Open-tES/Electronic/Open_tES.pdf

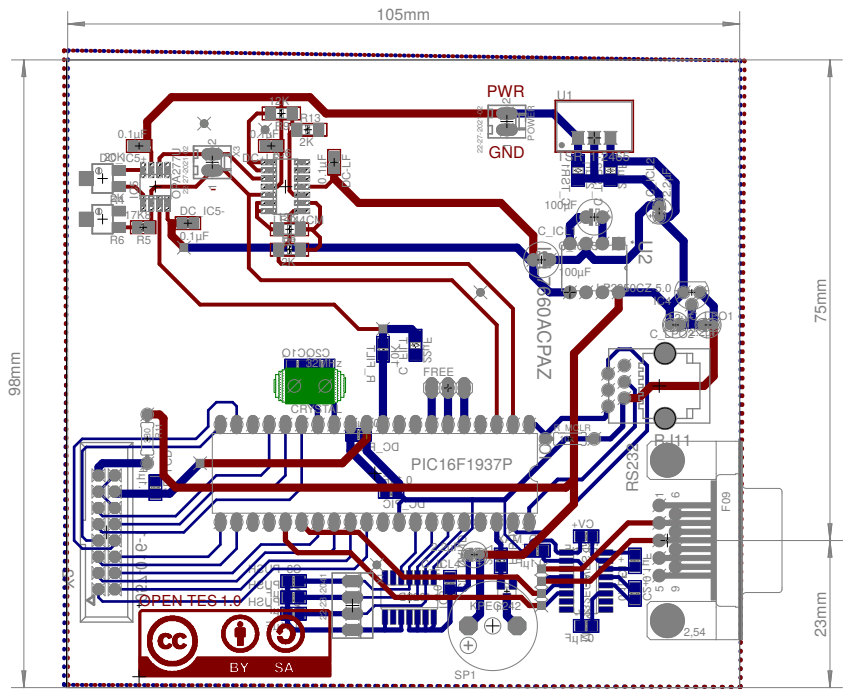
[picture p1: page 1]

Fp22 2K7 057-016-1 Fp22 22µF 22µF MAX232ECWES Fµ1. 0 Fµ1. 0 0.1µF0.1µF D3204 Fµ1. 0 0.1µF Fµ10. 0 Fµ10. 0 Fµ10. 0 22µF 10K 0.1µF Fµ1. 0 Fµ1. 0 Q2 C R_BUZZ X2 Q1 C C_TSR1 C_TSR2 2 CI +VC - VC C2+ C- 1+- IC3 CI P_ CD CD_NAND HSUP_3 C HSUP_2 C HSUP_1 C C_FILT R_FILT CD_LCD XA M_ DC 1 CI P_ CD 1T PWR GND - OPEN TES 1.0 1 59 6 2,54 F09 1 21 2 * RS232 CRYSTAL RJ11 R_MCLR R5 XIC6 3 R11 R1 R9 R13 R8 POWER U1 IC4 U2 C_ICL2 C_ICL1 C_ICL3 C_LPO1 SP1 R6 IC5 R4 DC_IC5+ DC_IC5- DC+LF DC-LF X1 C_LPO2 C_ICL4 FREE IC7 32MHz 10k 17K8 LF444CM 22-27-2021-02 330 12K 12K 2K 2K 22-27-2021-02 TSR_1-2465 LP2950CZ-5.0 ICL7660ACPAZ 2.2µF 100µF 100µF 2.2µF KPEG242 2K OPA277U20K0.1µF 0.1µF 0.1µF 0.1µF 22-23-2041 2.2µF 2.2µF PIC16F1937P 98mm 105mm 75mm 23mm
