Open-tES/Electronic/BOTTOM_PCB.pdf

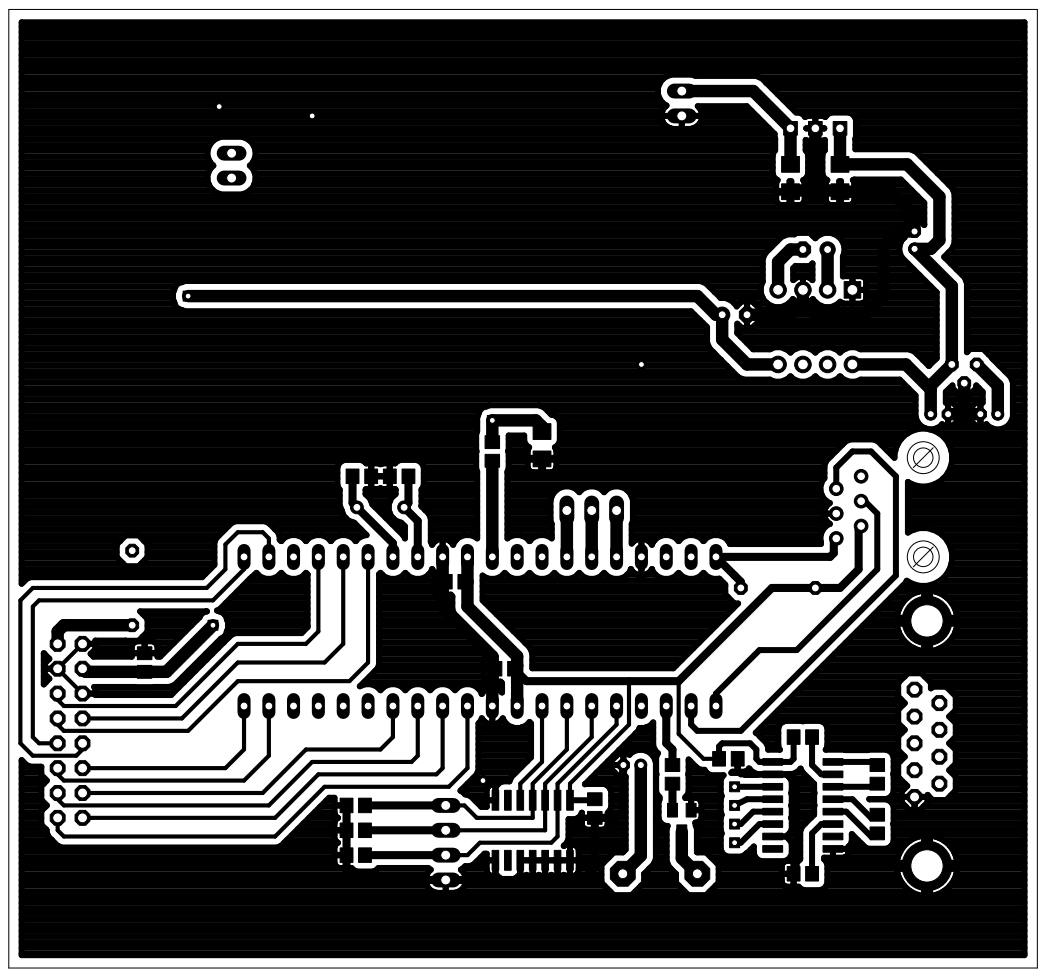
[picture p2: page 1]
