Open-tES/Electronic/TOP_PCB.pdf

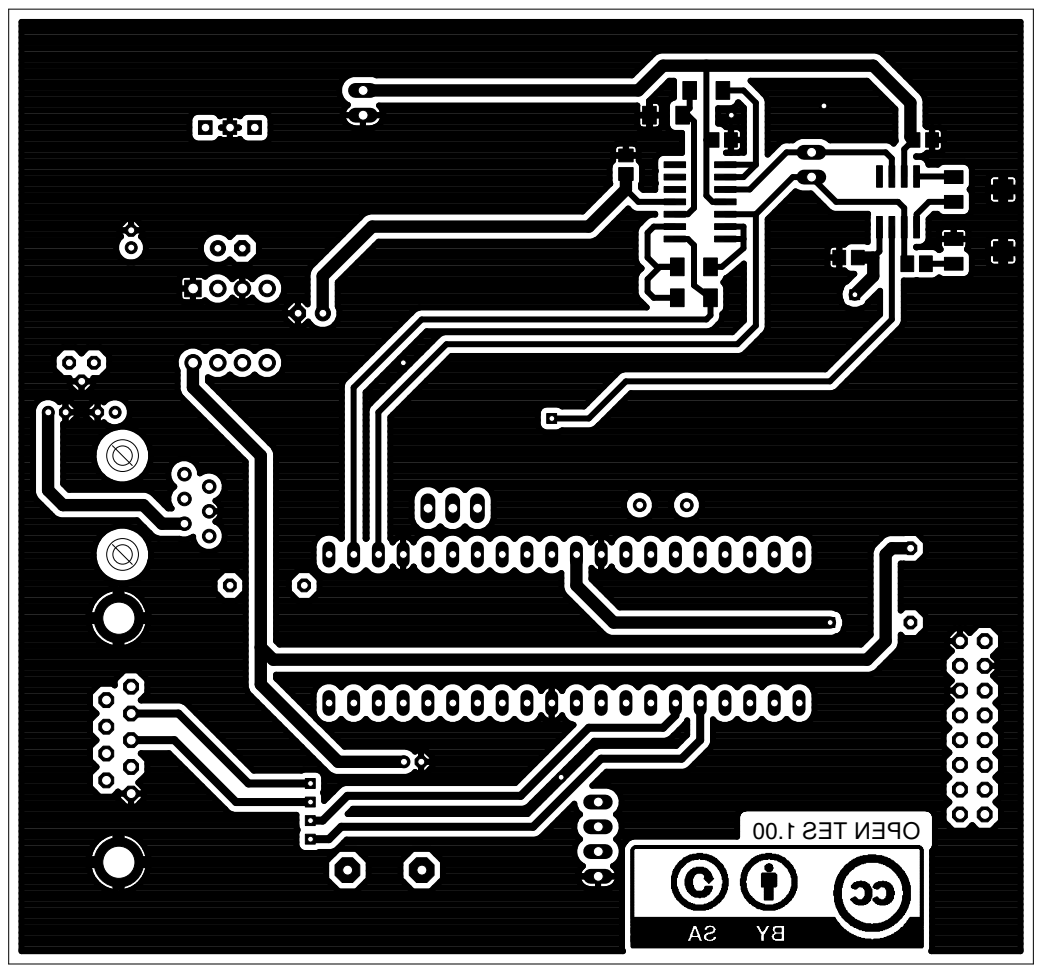
[picture p3: page 1]
