Open-tES/Electronic/Open_tES.brd

## EAGLE design Open_tES.brd (2016-03-02)

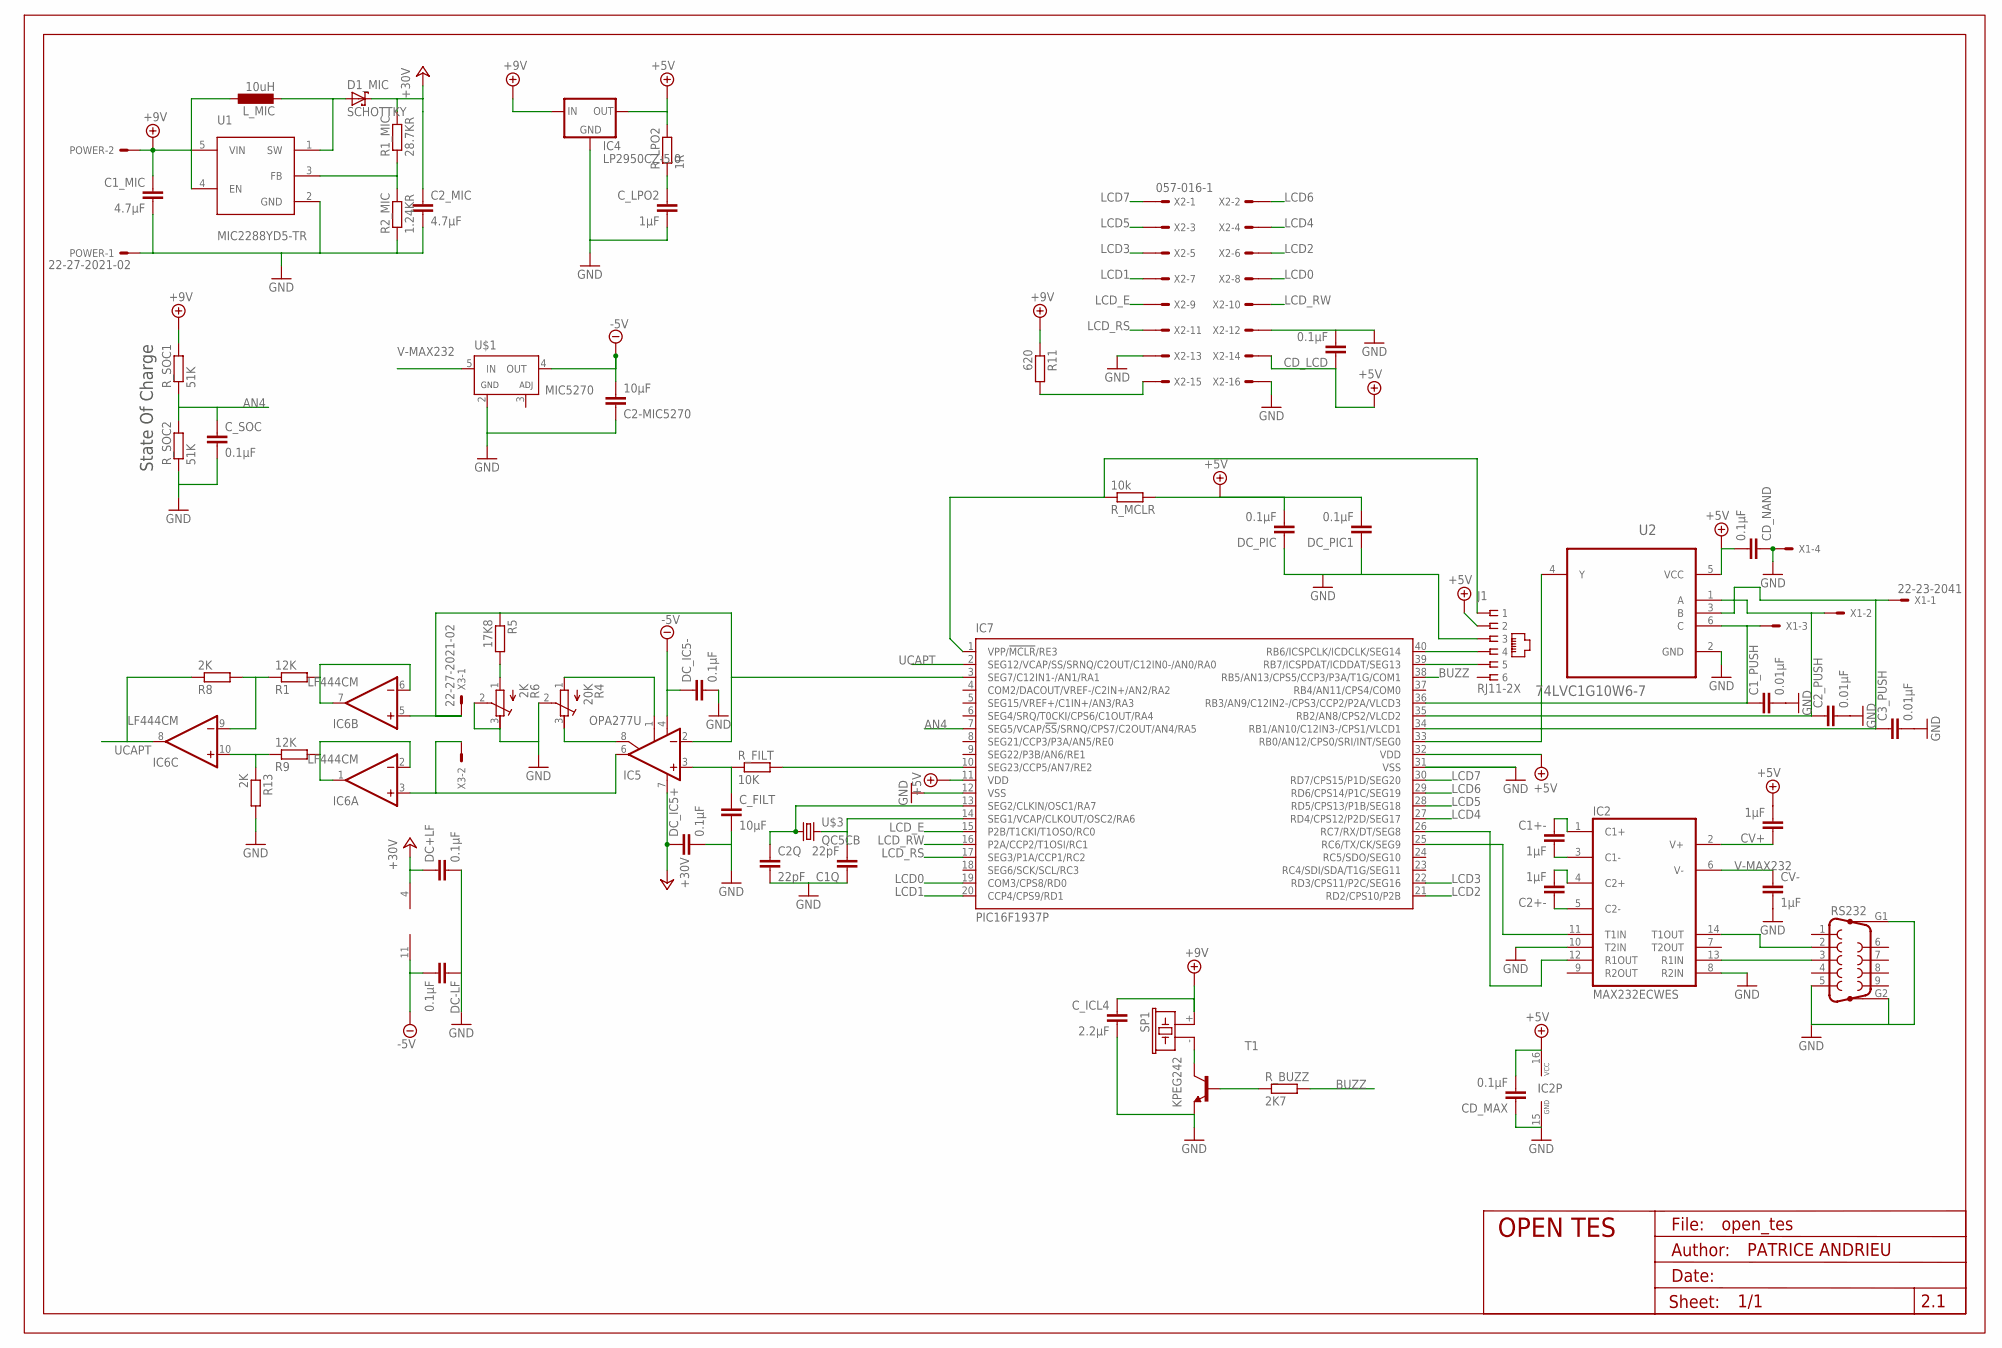
[picture p4: schematic Open_tES.sch]

Parts:
C1+-, C2+-: 1µF; C0805
C1Q, C2Q: 22pF; C0805
C1_MIC, C2_MIC: 4.7µF; C0805
C1_PUSH, C2_PUSH, C3_PUSH: 0.01µF; C0805
C2-MIC5270: 10µF; C0805
CD_LCD: 0.1µF; C0805
CD_MAX: 0.1µF; C0805
CD_NAND: 0.1µF; C0805
CV+: 1µF; C0805
CV-: 1µF; C0805
C_FILT: 10µF; C0805
C_ICL4: 2.2µF; C0805K
C_LPO2: 1µF; C0805
C_SOC: 0.1µF; C0805
D1_MIC: SCHOTTKY; SOD80
DC+LF: 0.1µF; C0805
DC-LF: 0.1µF; C0805
DC_IC5+, DC_IC5-: 0.1µF; C0805
DC_PIC, DC_PIC1: 0.1µF; C0805
IC2: MAX232ECWES; SO16
IC4: LP2950CZ-5.0; TO92
IC5: OPA277U; SO08
IC6: LF444CM; SO14
IC7: PIC16F1937P; DIL40
J1: RJ11-2X; RJ11-NO_SHIELD
L_MIC: 10uH; L2012C
POWER: 22-27-2021-02; 6410-02
R1, R9: 12K; R0805
R1_MIC: 28.7KR; R0805
R2_MIC: 1.24KR; R0805
R4: 20K; RTRIM3214W
R5: 17K8; M0805
R6: 2K; RTRIM3214W
R8, R13: 2K; R0805
R11: 620; 0204/7
RS232: F09HP
R_BUZZ: 2K7; R0805
R_FILT: 10K; R0805
R_LPO2: 1R; R0805
R_MCLR: 10k; 0204/7
R_SOC1, R_SOC2: 51K; R0805
SP1: KPEG242
T1: BFR92-NPN-SOT23-BEC; SOT23-BEC
U1: MIC2288YD5-TR; SOT23-5L
U2: 74LVC1G10W6-7; SOT95P280X135-6N
U$1: MIC5270; SOT23-5L
U$3: QC5CB
U$4: FRAME; OPEN_TE_VERSION
X1: 22-23-2041
X2: 057-016-1
X3: 22-27-2021-02; 6410-02

Connections:
+5V/1: CD_LCD.1, CD_MAX.2, CD_NAND.2, CV+.2, DC_PIC.2, DC_PIC1.2, IC2.16 (VCC), IC4.1 (OUT), IC7.11 (VDD), IC7.32 (VDD), J1.2, R_LPO2.2, R_MCLR.2, U2.5 (VCC), X2.14
+9V: C1_MIC.1, C_ICL4.1, IC4.3 (IN), L_MIC.1, POWER.2, R11.1, R_SOC1.2, SP1.+ (1), U1.4 (EN), U1.5 (VIN)
+30V: C2_MIC.1, D1_MIC.C, DC+LF.1, DC_IC5+.1, IC5.7 (V+), IC6.4 (V+), R1_MIC.2
-5V: C2-MIC5270.2, DC-LF.2, DC_IC5-.1, IC5.4 (V-), IC6.11 (V-), U$1.4 (OUT)
AN4: C_SOC.1, IC7.7 (SEG5/VCAP/!SS!/SRNQ/CPS7/C2OUT/AN4/RA5), R_SOC1.1, R_SOC2.2
BUZZ: IC7.38 (RB5/AN13/CPS5/CCP3/P3A/T1G/COM1), R_BUZZ.2
GND: C1Q.1, C1_MIC.2, C1_PUSH.2, C2-MIC5270.1, C2Q.2, C2_MIC.2, C2_PUSH.2, C3_PUSH.2, CD_LCD.2, CD_MAX.1, CD_NAND.1, CV-.2, C_FILT.2, C_ICL4.2, C_LPO2.2, C_SOC.2, DC+LF.2, DC-LF.1, DC_IC5+.2, DC_IC5-.2, DC_PIC.1, DC_PIC1.1, IC2.8 (R2IN), IC2.10 (T2IN), IC2.15 (GND), IC4.2 (GND), IC7.12 (VSS), IC7.31 (VSS), J1.3, POWER.1, R2_MIC.1, R4.2 (S), R6.2 (S), R6.3 (E), R13.2, RS232.5, RS232.G1, RS232.G2, R_SOC2.1, T1.E, U1.2 (GND), U2.2 (GND), U$1.2 (GND), X1.4, X2.12, X2.13, X2.16
ICAPT: IC5.2 (-IN), IC6.5 (+IN), IC7.3 (SEG7/C12IN1-/AN1/RA1), R5.1, X3.1
LCD0: IC7.19 (COM3/CPS8/RD0), X2.8
LCD1: IC7.20 (CCP4/CPS9/RD1), X2.7
LCD2: IC7.21 (RD2/CPS10/P2B), X2.6
LCD3: IC7.22 (RD3/CPS11/P2C/SEG16), X2.5
LCD4: IC7.27 (RD4/CPS12/P2D/SEG17), X2.4
LCD5: IC7.28 (RD5/CPS13/P1B/SEG18), X2.3
LCD6: IC7.29 (RD6/CPS14/P1C/SEG19), X2.2
LCD7: IC7.30 (RD7/CPS15/P1D/SEG20), X2.1
LCD_E: IC7.15 (P2B/T1CKI/T1OSO/RC0), X2.9
LCD_RS: IC7.17 (SEG3/P1A/CCP1/RC2), X2.11
LCD_RW: IC7.16 (P2A/CCP2/T1OSI/RC1), X2.10
MCLR: IC7.1 (VPP/!MCLR!/RE3), J1.1, R_MCLR.1
unnamed: SP1.- (2), T1.C
unnamed: IC6.6 (-IN), IC6.7 (OUT), R1.2
unnamed: C1+-.1, IC2.1 (C1+)
unnamed: R5.2, R6.1 (A)
unnamed: C2+-.2, IC2.4 (C2+)
unnamed: C1Q.2, IC7.14 (SEG1/VCAP/CLKOUT/OSC2/RA6), U$3.2
unnamed: IC2.14 (T1OUT), RS232.2
unnamed: IC2.13 (R1IN), RS232.3
unnamed: C3_PUSH.1, IC7.34 (RB1/AN10/C12IN3-/CPS1/VLCD1), U2.3 (B), X1.1
unnamed: R1_MIC.1, R2_MIC.2, U1.3 (FB)
unnamed: IC2.11 (T1IN), IC7.25 (RC6/TX/CK/SEG9)
unnamed: R_BUZZ.1, T1.B
unnamed: IC6.10 (+IN), R9.1, R13.1
unnamed: IC6.9 (-IN), R1.1, R8.2
unnamed: IC2.12 (R1OUT), IC7.26 (RC7/RX/DT/SEG8)
unnamed: IC5.8 (CMP2), R4.3 (E)
unnamed: IC6.1 (OUT), IC6.2 (-IN), R9.2
unnamed: C1_PUSH.1, IC7.36 (RB3/AN9/C12IN2-/CPS3/CCP2/P2A/VLCD3), U2.6 (C), X1.3
unnamed: C_FILT.1, IC5.3 (+IN), R_FILT.1
unnamed: C2Q.1, IC7.13 (SEG2/CLKIN/OSC1/RA7), U$3.1
unnamed: C_LPO2.1, R_LPO2.1
unnamed: C1+-.2, IC2.3 (C1-)
unnamed: C2_PUSH.1, IC7.35 (RB2/AN8/CPS2/VLCD2), U2.1 (A), X1.2
unnamed: IC7.33 (RB0/AN12/CPS0/SRI/INT/SEG0), U2.4 (Y)
unnamed: IC5.1 (CMP1), R4.1 (A)
unnamed: IC5.6 (OUT), IC6.3 (+IN), X3.2
unnamed: C2+-.1, IC2.5 (C2-)
unnamed: CV+.1, IC2.2 (V+)
unnamed: R11.2, X2.15
unnamed: D1_MIC.A, L_MIC.2, U1.1 (SW)
PGC: IC7.39 (RB7/ICSPDAT/ICDDAT/SEG13), J1.5
PGD: IC7.40 (RB6/ICSPCLK/ICDCLK/SEG14), J1.4
PWM: IC7.10 (SEG23/CCP5/AN7/RE2), R_FILT.2
UCAPT: IC6.8 (OUT), IC7.2 (SEG12/VCAP/SS/SRNQ/C2OUT/C12IN0-/AN0/RA0), R8.1
V-MAX232: CV-.1, IC2.6 (V-), U$1.5 (IN)

Notes on the sheet:
State Of Charge

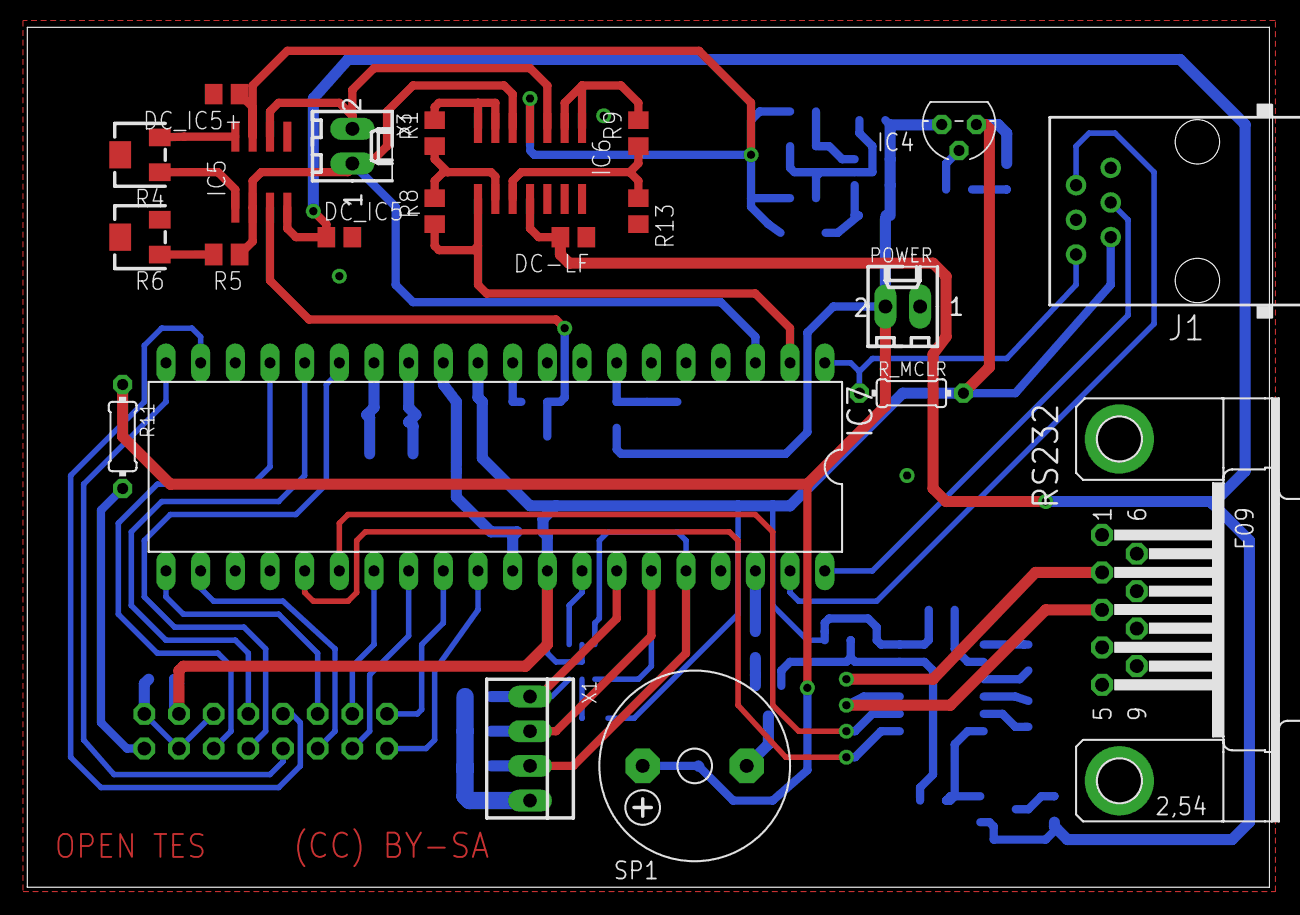
[picture p5: board Open_tES.brd from above]

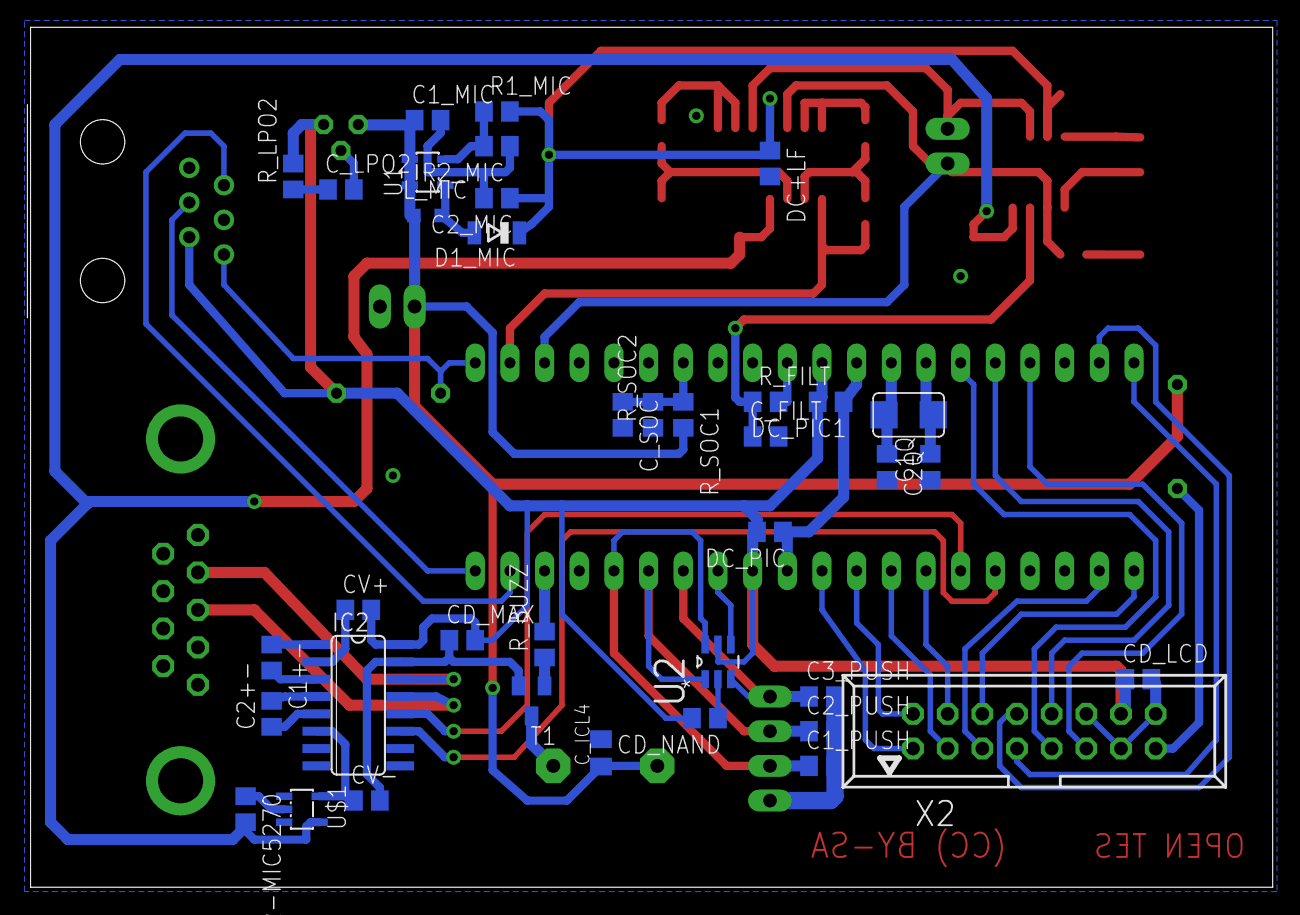
[picture p6: board Open_tES.brd from below]

Board: 2 copper layers, 91.0 x 63.0 mm, 61 parts (38 on the bottom side), 55 nets.
