Open-tES/Electronic/(commit log)

2016-01-20 Adding of files project -first commit-
    [Open_tES.brd, Open_tES.sch, Open_tES_PartList.csv]
2016-01-20 removing supply 28+(not used)
    [Open_tES.sch]
2016-01-21 replace TSR on the shematic by MIC2288 boost DC-DC
    [Open_tES.brd, Open_tES.sch]
2016-01-21 backlight resistor for 9V supply
    [Open_tES.brd, Open_tES.sch]
2016-01-22 use of MAX232 for negative voltage with MIC5270 for regulation (-5V)
    [Open_tES.brd, Open_tES.sch]
2016-01-22 Changing of RJ connector with 90deg connector to ease PIC programming. Need a new hole in back end plate
    [Open_tES.sch]
2016-01-22 1)replace 4023 triple 3-input NAND with 74LVC1G10W6-7 simple 3-input NAND 2) solve consistent problem between sch and brd
    [Open_tES.brd, Open_tES.sch]
2016-01-22 update version on the schem and board -2.0-
    [Open_tES.brd, Open_tES.sch]
2016-01-25 fixing of connecting error +9V and +30V. MIC2288 and LP2950 was concerned. Correction of capacitor for LPO.
    [Open_tES.brd, Open_tES.sch]
2016-01-25 Removing input capacitor for LPO: C1_MIC already present.
    [Open_tES.brd, Open_tES.sch]
2016-02-03 Adding of state of charge module connecting to AN4: firmware updating is necessary. End of routing
    [Open_tES.brd, Open_tES.sch]
2016-02-08 Changing of C_FILT value 22->10uc to simplify the circuit. The same capacitor is already used on the board : C2-MIC5270
    [Open_tES.brd, Open_tES.sch]
2016-02-08 replace package of R1 R8 R9 R13 MELF->0805 to reduce the cost. Update version 2.0->2.1 in files
    [Open_tES.brd, Open_tES.sch]
2016-03-02 Fixing of several mistakes concerning component references. Changing of package for the trimmers R4 R6.
    [Open_tES.brd, Open_tES.sch]
